briancappello/level-2-ev-charge-bridge/datasheets/README.md

# Datasheets

Reference documents for the 9.6 kW Level 2 EVSE build (`../cb-l2-evse.html`).
The eval board's KiCad files are in `../cb-eval-board/`.

| Part | Ref | File |
|---|---|---|
| ChargeBridge module (CB-CCS-EVSE-LU), v1.2 Jan 2026 | A1 | `Pionix_ChargeBridge_Module_Datasheet_v1.2_Jan-2026.pdf` |
| CB-EVAL evaluation board, v1.1 Jun 2025 (J11 pin table is out of date; the v1.2 schematic is authoritative) | A1 | `Pionix_CB-EVAL_Datasheet_v1.1_Jun-2025.pdf` |
| TI TPS27S100 high-side switch (the board's relay drivers) | A1 | `TI_TPS27S100_high-side_switch.pdf` |
| Phoenix UM-PRO-SKT-B108-L120-7035 board housing | — | `Phoenix_UM-PRO-SKT-B108-L120-7035_1456980.pdf` |
| Phoenix UT 16 feed-through terminal | TB1 | `Phoenix_UT16_3044199.pdf` |
| Phoenix UT 16-PE ground terminal | PE1–PE3 | `Phoenix_UT16-PE_3044212.pdf` |
| ABB ESB63-20N-01 contactor | K1 | `ABB_ESB63-20N-01_product_sheet.pdf` |
| ABB ESB/EN installation contactor catalog (dimensions, terminal layout) | K1 | `ABB_ESB-EN_installation_contactors_catalog.pdf` |
| ABB EH04-11N auxiliary contact | K1 aux | `ABB_EH04-11N_aux_contact.pdf` |
| Shelly EM Gen3 user and safety guide | M1 | `Shelly_EM_Gen3_user_guide.pdf` |
| Eastron SDM230-Modbus manual V1.9 (earlier M1, replaced) | — | `Eastron_SDM230-Modbus_manual_V1.9.pdf` |
| Yageo Nexensos EC3032 (5016951) and EC series PT1000 probes | TT1, TT2 | `Yageo_Nexensos_EC3032_5016951.pdf`, `Yageo_Nexensos_EC-series_PT1000.pdf` |
| Mean Well HDR-60 series | PS1 | `MeanWell_HDR-60_spec.pdf` |
| Eaton FAZ-C2/2 MCB (two revisions) | F1, F2 | `Eaton_FAZ-C2-2_datasheet.pdf`, `Eaton_FAZ-C2-2_datasheet_alt-rev.pdf` |
| Eaton FAZ family spec (AutomationDirect) | F1, F2 | `AutomationDirect_Eaton_FAZ_spec.pdf` |
| Schneider XB5AA31 pushbutton (earlier S2, replaced by GCX1100) | — | `Schneider_XB5AA31_pushbutton.pdf` |
| Schneider XB5AVB3 pilot light | H1 | `Schneider_XB5AVB3_pilot_light.pdf` |
| AutomationDirect GCX 22 mm operators (GCX3131 E-stop, GCX1100 pushbuttons) | S1, S2, S3 | `AutomationDirect_GCX_22mm_operators_spec.pdf` |
| Bimed cable glands catalog | glands | `Bimed_cable_glands_catalog.pdf` |
| Bimed glands spec (AutomationDirect) | glands | `AutomationDirect_Bimed_glands_spec.pdf` |
| Bimed BM-ENX-15-W M40 gland, spec and drawing | glands | `Bimed_BM-ENX-15-W_M40.pdf`, `Bimed_BM-ENX-15-W_M40_drawing.pdf` |
| Bimed BM-ENX-12-W M20 gland, spec and drawing | glands | `Bimed_BM-ENX-12-W_M20.pdf`, `Bimed_BM-ENX-12-W_M20_drawing.pdf` |

Not included: Polycase ZH-161407 and DR-62 (the site blocks automated downloads; the saved product page is in `../polycase/`), Phoenix D-UT 16, E/UK and FBS 2-12 accessories and the Inteset J1772 cable.
