briancappello/level-2-ev-charge-bridge/scripts/data/prices/groupA.md

| Ref | Item | MPN | Vendor | URL | Unit price (USD unless stated) | Qty | Stock / notes |
|---|---|---|---|---|---|---|---|
| A1 | ChargeBridge Evaluation Kit CCS – EVSE side (EVAL carrier board + CB-CCS-EVSE-LU module + 24 V PSU) | CB-EVAL-CCS-EVSE-LU-KIT | Pionix (shop.pionix.com) | https://shop.pionix.com/products/chargebridge-development-kit-pn-1015 | **€750.00 (EUR, net, excl. VAT)** | 1 | Shopify shows available. Store says "prices shown are net prices". United States is in the country selector. Shipping policy: Rest of World €200 (0–5 kg), €280 (>5.1 kg); EU €150; DE €40/€60. US duties/tariffs not stated. Kit includes a 24 V power supply. |
| A1 (ref) | [Bundle] ChargeBridge Evaluation Kit – EVSE + CAR side | — | Pionix | https://shop.pionix.com/products/chargebridge-evaluation-kit-evse-car-side | €1,600.00 (EUR, net) | 1 | Available. For reference: car-side kit alone (CB-EVAL-CCS-EV-LU-KIT) is €950; AC charger kit (pn-1016) is €750. |
| — | Phoenix Contact UM-PRO housing set for 108×120 mm PCB (incl. 2 side elements) | UM-PRO-SKT-B108-L120-7035 (Phoenix PN 1456980) | WSU Industrials (Germany) | https://wsu-industrials.com/en/phoenix-contact-1456980-housing-set-um-pro-skt-b108-l120-7035 | €11.49 (EUR, incl. German VAT, plus shipping; regular price €17.67) | 1 | Not on Digi-Key (no results for the MPN or for 1456980). US shipping from WSU not checked. Phoenix US site and Octopart blocked the bot. Alternative US source: Neff Automation, https://shop.neffautomation.com/products/1456980 ("contact for availability", no price). |
| — | (Fallback) Phoenix UM 108 profile base, 1000 mm × 108 mm, cut to length | 2907525 | Digi-Key | https://www.digikey.com/en/products/result?keywords=UM108-PROFIL | $119.31 | 1 | 14 in stock, **Last Time Buy**. You also need UM108 DIN-rail foot elements (not priced). Costly for one board, so the UM-PRO set above is the better buy. |
| U1 | Raspberry Pi 5 4GB | SC1111 (PiShop SKU 4GB-9024) | PiShop.us (authorized reseller) | https://www.pishop.us/product/raspberry-pi-5-4gb/ | $110.00 | 1 | IN STOCK |
| U1 (opt.) | DIN-rail ABS case for Raspberry Pi 5 | PI5-CASE-DIN-RAIL-B (Waveshare SKU 26682) | Waveshare (ships from China) | https://www.waveshare.com/pi5-case-din-rail-b.htm | $3.99 (qty 1–9) | 1 | Nice-to-have. Shipping not checked. Also sold on Amazon US: https://www.amazon.com/clp/B0CT865FQP (price not shown). |
| PS2 | Mean Well DIN-rail DC-DC, 9–36 V in, 5 V 6 A, 30 W | DDR-30G-5 | TRC Electronics (Mean Well authorized distributor) | https://www.trcelectronics.com/products/mean-well-ddr-30g-5 | $35.36 (5+: $33.57) | 1 | In stock: 50. Site says import tariff is included in the price. Digi-Key: "no longer available". Newark: $37.68, 93 in stock (UK stock), https://www.newark.com/mean-well/ddr-30g-5/dc-dc-converter-5v-6a/dp/01AH7065 |
| PS1 | Mean Well DIN-rail AC/DC 24 V 2.5 A 60 W | HDR-60-24 | Digi-Key (1866-2249-ND) | https://www.digikey.com/en/products/detail/mean-well-usa-inc/HDR-60-24/7703804 | $20.90 | 1 | In stock: 2,367 |
| R1, R2 | 2.2 kΩ 1% 0.5 W axial metal film | MFR50SFTE52-2K2 (Yageo) | Digi-Key | https://www.digikey.com/en/products/result?keywords=MFR50SFTE52-2K2 | $0.10 (Cut Tape) | 2 | 28,416 in stock, no minimum (qty 1). Alternative: Vishay SFR25H0002201FR500, $0.18, 3,296 in stock. Avoid MFR-50FRF52-2K2: Digi-Key doesn't stock it and sells only full reels. |
| R3 | 4.7 kΩ 1% 0.5 W axial metal film | MFR50SFTE52-4K7 (Yageo) | Digi-Key | https://www.digikey.com/en/products/result?keywords=MFR50SFTE52-4K7 | $0.10 | 1 | Exact match listed at $0.10. Stock count not shown in the captured text. |
| TT1, TT2 | Pt1000 2-wire RTD surface sensor, self-adhesive patch, PFA leads, 2 ft | P2A-TAPE-REC-PK-1-PFXX-24-STWL | Evolution Sensors (evosensors.com, US) | https://evosensors.com/products/2-wire-rtd-pt1000-surface-temperature-sensor-with-self-adhesive-patch-and-with-2-4-or-8ft-of-lead-wire | $50.00 (4 ft $55, 6 ft $58, 8 ft $63) | 2 | Available. Ring-lug option: 2-wire Pt1000 bolt-on with 20 ft leads, P2A-BDFT-REC-PK-0.31-PFXX-240-STWL, $90, available. |

**Not verified:**
- Pionix: no US-specific shipping terms, duties, or lead time are stated. € prices are net; whether a US order is charged VAT wasn't confirmed. No USD price is shown.
- UM-PRO-SKT-B108-L120-7035: no US-based distributor price found. Digi-Key doesn't carry it, Mouser was skipped, and Phoenix/Octopart/Arrow blocked the bot. The WSU price is a German shop's, and US shipping wasn't confirmed. UM108 foot elements for the fallback weren't priced.
- MFR50SFTE52-4K7: stock quantity not shown in the captured page. The 2.2 kΩ version shows 28,416 in stock.
- Waveshare case: shipping cost and time to the US not checked. The Amazon US listing's price wasn't fetched.
