briancappello/level-2-ev-charge-bridge/scripts/data/prices/groupB.md

| Ref | Item | MPN | Vendor | URL | Unit price (USD) | Qty | Stock / notes |
|---|---|---|---|---|---|---|---|
| TB1/TB2 | Phoenix UT 16 feed-through terminal block, 16 mm², 76 A (IEC) / 85 A (UL) | 3044199 | Digi-Key (277-3254-ND) | https://www.digikey.com/en/products/detail/phoenix-contact/3044199/2426230 | $2.44 | 4 | 2,334 in stock |
| TB end cover | End cover D-UT 16 (the correct cover for UT 16) | 3047206 | Digi-Key | https://www.digikey.com/en/products/result?keywords=3047206 | $0.74 | 1–2 | 1,956 in stock (shown as an associated product on the 3044199 page: "End Plate For CLIPLINE UT"). **Not 3047293**: that part is D-UTTB, the cover for the double-level UTTB blocks |
| TB end clamp | End clamp E/UK | 1201442 | Digi-Key | https://www.digikey.com/en/products/result?keywords=1201442 | $1.53 | 2 | In stock |
| PE | UT 16-PE ground terminal, green-yellow | **3044212** | Digi-Key (277-3344-ND) | https://www.digikey.com/en/products/detail/phoenix-contact/3044212/2435394 | price not shown | 1 | Page loaded without a price, then Cloudflare blocked the retry. **3044225 is the wrong part number**: Digi-Key lists it as a gray feed-through block for 1/0–14 AWG (UT 35 size), $5.24 |
| K1 | ABB ESB63-20N-01 installation contactor, 2NO, 63 A AC-1, 24 V AC/DC coil | ESB63-20N-01 / 1SAE351111R0120 | TME (US site, ships from Poland) | https://www.tme.com/us/en-us/details/esb63-20n-01/contactors-installation-modular/abb/1sae351111r0120/ | $115.48 (TME says customs and tariffs are included) | 1 | 4 in stock at TME |
| K1 (alt. seller) | same | 1SAE351111R0120 | Amazon, sold by Kempston Controls USA | https://www.amazon.com/1SAE351111R0120-ESB63-20N-01-ABB-Installation-CONTACTOR/dp/B097HMNFFJ | price not shown (search snippet said $377.57) | 1 | Wiautomation US shows $106.72 in its search snippet, but the page was blocked by Cloudflare |
| K1 aux | ABB EH04-11N auxiliary contact, 1NO+1NC, for ESB..N / EN..N | EH04-11N / 1SAE901901R1011 | TME | https://www.tme.com/us/en-us/details/eh04-11n/contactors-installation-modular/abb/1sae901901r1011/ | $26.12 | 1 | 105 in stock |
| F1/F2 opt. A | 2-pole Class CC DIN fuse holder, 30 A 600 V | EHCC2DU (Edison/Eaton) | AutomationDirect | https://www.automationdirect.com/adc/shopping/catalog/circuit_protection_-z-_fuses_-z-_disconnects/fuse_holders/modular_fuse_holders/ehcc2du | $52.00 | 1 | 66 available. The page warns of possible extended lead times |
| F1/F2 opt. A | Class CC 2 A time-delay fuse | HCTR2 (Edison) | AutomationDirect | https://www.automationdirect.com/adc/shopping/catalog/circuit_protection_-z-_fuses_-z-_disconnects/fuses/current_limiting_class_cc_fuses/hctr2 | $207.00 per pack of 10 | 1 pk | Backordered, earliest 10/30/2026 |
| F1/F2 opt. A' | Littelfuse 2-pole Class CC holder with blown-fuse indicator | LPSC002ID | Amazon (seller ZenSupplyInc) | https://www.amazon.com/Littelfuse-LPSC002ID-POWR-SAFE-Holder-Indicator/dp/B00JV3ED5U | $137.84 | 1 | 11 left, plus $11.99 shipping. Distributor price not obtained |
| F1/F2 opt. A' | Littelfuse Class CC 2 A time-delay fuse | KLDR002 | Amazon (seller Witonics of USA) | https://www.amazon.com/Littelfuse-KLDR-2-KLDR002-2Amp-Cartridge/dp/B00O6Y7ZHC | $9.09 each | 2 | In stock. Other sellers from $5.59 |
| F1/F2 opt. B | Eaton FAZ 2-pole 2 A C-curve MCB, UL 489, 277/480 V | FAZ-C2/2-NA | AutomationDirect (FAZ-C2-2-NA) | https://www.automationdirect.com/adc/shopping/catalog/circuit_protection_-z-_fuses_-z-_disconnects/circuit_breakers_-a-_circuit_protectors/miniature_circuit_breakers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 | $86.00 | 1 | 14 available |
| F1/F2 opt. B' | Eaton FAZ 2-pole 2 A C-curve supplementary protector, UL 1077 | FAZ-C2/2 | AutomationDirect (FAZ-C2-2) | https://www.automationdirect.com/adc/shopping/catalog/circuit_protection_-z-_fuses_-z-_disconnects/circuit_breakers_-a-_circuit_protectors/miniature_supplementary_pr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 | $46.00 | 1 | 94 available. UL 1077 is supplementary protection only, not branch-circuit protection. WMS2C02 is retired at AutomationDirect |
| SPD | Eaton CHSPT2ULTRA whole-home Type 2 SPD, 120/240 V, 108 kA | CHSPT2ULTRA | Amazon (seller FARA KITCHEN STORE) | https://www.amazon.com/EATON-CHSPT2ULTRA-SURGE-PROTECTOR-108KA/dp/B00DJS8MGY | $180.00 | 1 | In stock, $10 delivery. Third-party seller. Plugs into a CH load-center slot, so it is **not DIN-rail mounted**. Home Depot and Lowe's pages did not load |
| DIN rail | 35 × 7.5 mm slotted steel DIN rail, 1 m | DN-R35S1-2 (DINnector) | AutomationDirect | https://www.automationdirect.com/adc/shopping/catalog/wire_-a-_cable_management/din_rail/din_rail/dn-r35s1-2 | $9.25 per pack of 2 × 1 m | 1 pk | 590 available. Alternative: Phoenix 1206421, 2 m slotted, $16.32 at Digi-Key (in stock) |

**Could not verify**
- UT 16-PE (3044212): no Digi-Key price because Cloudflare blocked the page. The correct part number is 3044212, not 3044225.
- 3047293 is D-UTTB, the wrong end cover. Use D-UT 16 (3047206).
- ESB63 on Wiautomation ($106.72) and Amazon/Kempston ($377.57): these prices come from search snippets only, because the pages were blocked or not fetched. TME's $115.48 was seen on the page. I found no ABB-authorized US distributor price. The ESB63 is available to US buyers, so I did not price an alternative contactor.
- Digi-Key was blocked by Cloudflare for LPSC002ID, KLDR002, CHCC2DU and FNQ-R-2. The Amazon prices above come from third-party sellers.
- EH04-11N minimum switching load: >17 V / >5 mA. This figure comes from a reseller page (wheat-industrial.com). I could not fetch ABB's own datasheet to confirm it. Rated 6 A thermal; AC-15: 3 A at 415 V; DC-13: 0.55 A at 125 V.
