briancappello/level-2-ev-charge-bridge/scripts/data/prices/groupC.md

# Group C pricing (checked 2026-10-26, ship-to US)

| Ref | Item | MPN / description | Vendor | URL | Price (USD) and unit | Qty needed | Stock / notes |
|---|---|---|---|---|---|---|---|
| CB1 | 50 A 2-pole GFCI breaker (QO) | Square D QO250GFI | Amazon | https://www.amazon.com/SQUARE-QO250GFI-Circuit-Breaker-240V-AC/dp/B07SSF49TM | $135.00 each | 1 (one of the CB1 options) | "Only 4 left in stock". Home Depot (QO250GFIC, https://www.homedepot.com/p/Square-D-QO-50-Amp-2-Pole-GFCI-Circuit-Breaker-QO250GFIC-QO250GFIC/202495832) and Lowe's blocked the bot, so their prices were not shown |
| CB1 | 50 A 2-pole GFCI breaker (Siemens QP) | Siemens QF250A | Amazon (shipped and sold by Amazon.com) | https://www.amazon.com/Siemens-QF250A-Ground-Circuit-Interrupter/dp/B01H04XG6S | $109.75 each | 1 (option) | In stock. Other sellers start at $92.00. HD QF250AP (https://www.homedepot.com/p/Siemens-50-Amp-Double-Pole-Type-QPF-GFCI-Circuit-Breaker-US2-QF250AP/206965332): price not shown (blocked) |
| CB1 | (alt vendor) | Siemens QF250A | SuperBreakers | https://superbreakers.com/products/siemens-qf250a-50-amp | $179.80 each | – | Shows as available |
| CB1 | 50 A 2-pole GFCI breaker (Eaton BR) | Eaton BRN250GF (current pigtail version of BR250GF) | Amazon (sold by FLARETEK, ships from Amazon) | https://www.amazon.com/Eaton-BRN250GF-Circuit-Breaker-Two-Pole/dp/B0CTS1TWHF | $88.75 each | 1 (option) | In stock. HD BRN250GFCS (https://www.homedepot.com/p/Eaton-BR-50-Amp-120-Volt-240-Volt-2-in-2-Pole-GFCI-Circuit-Breaker-Pigtail-Neutral-BRN250GFCS/326936267): price not shown (blocked). SimplyBreakers lists it at $150.99 (in stock); BreakerOutlet at $99.90 (sold out). Eaton CH GFTCB250: not priced |
| W1 | 6/2 NM-B W/G, stranded, 50 ft coil | Southwire Romex SIMpull 28894422 | Amazon (sold by TheHardwareCityCom, ships from Amazon) | https://www.amazon.com/dp/B00PDF1FOM | $180.93 per 50 ft coil | 1 coil (or as the run needs) | In stock. SupplyHouse: $362.85 per 50 ft (backordered). HardPowerSystems: $207.00 per 50 ft. HD (https://www.homedepot.com/p/Southwire-50-ft-6-2-Stranded-Romex-SIMpull-CU-NM-B-W-G-Wire-28894422/205357757): price not shown |
| – | 8 AWG stranded THHN/THWN-2 Cu (black, red, green) | Cut to length, SKU THN8 | Wire & Cable Your Way | https://www.wireandcableyourway.com/8-awg-thhn-building-wire | $0.87 per ft | ~3–6 ft per colour | Stranded confirmed (category "Stranded THHN/THWN-2"). Black and Green are in the colour list; Red not confirmed. $20 minimum order |
| – | Ferrule kit with 10 mm² (8 AWG) ferrules + ratchet crimper | LUNEY 1250 pcs, AWG 23-7 (0.25–10 mm²) | Amazon (sold by panda mimi, ships from Amazon) | https://www.amazon.com/dp/B0B23V7ZQJ | $13.98 per kit | 1 | In stock |
| – | 18 AWG stranded MTW, blue | Atlas MTW18BL, 500 ft spool | AutomationDirect | https://www.automationdirect.com/adc/shopping/catalog/bulk_wire_-a-_cable/single_conductor_wire_-a-_cable/mtw18bl | $49.00 per 500 ft spool | ~10 ft | Backordered, earliest 11/12/2026. Alt: Wire & Cable Your Way MTW18 (https://www.wireandcableyourway.com/18-awg-type-mtw-ul1015-wire-16-strand-500-or-1000-spool) at $0.13/ft, sold by spool only (500/1000 ft) |
| – | RS-485 shielded twisted pair | Belden 9841, 24 AWG 1 pair, shielded, 120 Ω | Wire & Cable Your Way | https://www.wireandcableyourway.com/belden-9841-24-awg-1-pair-shielded-low-capacitance-computer-cable | $3.55 per ft | ~3–6 ft | Stock not shown. $20 minimum order |
| X1 | J1772 tethered cable, 48 A, 25 ft (option 1) | Inteset 48A J1772 replacement cable, 8 AWG, bare-wire charger end, Made in USA | Amazon (Inteset) | https://www.amazon.com/Inteset-Charger-Replacement-Original-Chargers/dp/B0FV116C88 | $219.95 each | 1 | "Only 2 left in stock". 48 A continuous, 25 ft, IP65. Listing does not say whether there is a latch-button sense wire. A 40 A 25 ft version from the same search was $179.95 (URL not captured) |
| X1 | J1772 tethered cable, 48 A, 25 ft (option 2) | Phoenix Contact EV-T1G2C-1AC48A-25FT12ASBK11U ("Standard" ferrule termination) | OpenEVSE store | https://store.openevse.com/products/j1772-cable-48a-ultra-flexible | $229.00 each | 1 | Backordered, 3–4 week lead time. cULus, 48 A max. 9 conductors (4×12 AWG, 1×10 AWG, 4×22 AWG). Sense wire not explicitly stated |
| – | J1772 wall holster / dock | J1772 Wall Mount EV Plug Holder | EVSE Adapters | https://www.evseadapters.com/products/j1772-plug-holder | $9.95 each | 1 | Available. OpenEVSE holster v2 is $24.99 but sold out |
| M1 | Eastron SDM230-Modbus, 100 A, RS-485 | "SDM230 … RS485/Modbus Output Non MID" (unbranded listing) | Amazon (seller chenhongqingCHQ) | https://www.amazon.com/SDM230-Single-Energy-Bi-Directional-Function/dp/B0DKFF2Z83 | $41.00 each | 1 | Non-MID. In stock, but delivery is Nov 5–13, so it likely ships from overseas. Genuine Eastron not verified |
| M1 | (alt) | YYAZYYZ SDM230-Modbus MID | Amazon (third party) | https://www.amazon.com/YYAZYYZ-SDM230-Modbus-Energy-Communicate-Systems/dp/B0G5Y9BVXW | $79.10 each | – | MID version. Delivery Nov 13–24, so it ships from overseas. No US-located genuine Eastron seller found (eBay US search: 0 exact results) |
| RCM1 | 6 mA DC RCM module, relay output | Littelfuse/Western Automation RCM14-03 | Digi-Key | https://www.digikey.com/en/products/detail/littelfuse-western-automation/RCM14-03/19183160 | $36.38 each (qty 1) | 1 (optional) | In stock: 97. Tariff may apply |
| RCM1 | (alt) | Littelfuse/Western Automation RCM14-01 | Digi-Key | https://www.digikey.com/en/products/detail/littelfuse-western-automation/RCM14-01/19183167 | $36.38 each (qty 1) | – | In stock: 160. No backorders accepted |

**Could not verify:**
- Home Depot and Lowe's blocked the bot, so no HD/Lowe's prices for any breaker, the Romex or the 8 AWG wire.
- Eaton CH GFTCB250: not priced. Eaton BRN250GF was priced instead of BR250GF, which has been superseded by the pigtail BRN version.
- 8 AWG red THHN in stock at Wire & Cable Your Way (only black and green confirmed). Also no 25 ft spool price.
- Whether either J1772 cable has a latch-button sense wire (neither listing says).
- The Amazon SDM230 listings are unbranded third-party sellers shipping from overseas. Genuine Eastron is not confirmed, and no US-stock seller was found.
- No price for a Bender, Dold or UL CCID20 alternative for RCM1 (not searched further, since the RCM14 parts are in stock at Digi-Key).
- Mouser was not checked because it blocks the bot.
