briancappello/level-2-ev-charge-bridge/scripts/data/prices/groupD.md

| Ref | Item | MPN | Vendor | URL | Unit price (USD) | Qty | Stock / notes |
|---|---|---|---|---|---|---|---|
| S1 | E-stop, 22 mm, 40 mm red mushroom, turn-to-release, 1 NC | Schneider XB5AS8444 | Digi-Key | https://www.digikey.com/en/products/result?keywords=XB5AS8444 | $121.28 | 1 | Exact match on Digi-Key search. Stock count not shown on the results page. |
| S1 extra | Add-on contact block, 1 NC, screw clamp | Schneider ZBE102 | Digi-Key | https://www.digikey.com/en/products/result?keywords=ZBE102 | $12.05 | 1 | Correct part: Schneider/dealer pages say ZBE102 fits both XB4 (metal) and XB5 (plastic). ZB5AZ102 is a body with a fixing collar, not an add-on block. Stock count not shown. |
| S2 (preferred) | 22 mm pushbutton, black, spring return (momentary), 1 NO | Schneider XB5AA31 | Digi-Key | https://www.digikey.com/en/products/result?keywords=XB5AA31 | $28.30 | 1 | Momentary NO, matches the input requirement. Stock count not shown. |
| S2 (alt) | 22 mm key selector, 2-position, stay-put (maintained), 1 NO | Schneider XB5AG21 | Digi-Key | https://www.digikey.com/en/products/result?keywords=XB5AG21 | $90.41 | 1 | Maintained, not momentary. Stock count not shown. |
| H1 | 22 mm LED pilot light, 24 V AC/DC, green | Schneider XB5AVB3 | Digi-Key | https://www.digikey.com/en/products/result?keywords=XB5AVB3 | $52.92 | 1 | Digi-Key's short description says "30MM", which looks like a listing error (XB5AV is a 22 mm series). Stock count not shown. |
| H1 (alt) | 22 mm LED pilot light, 24 V AC/DC, red | Schneider XB5AVB4 | Digi-Key | https://www.digikey.com/en/products/result?keywords=XB5AVB4 | $52.92 | 1 | Same as above. |
| Encl (opt A) | NEMA 4X polycarbonate enclosure, 16 x 14 x 7 in, clear hinged door, quick-release latch | Integra H161407HCFNL-P10 | AutomationDirect | https://www.automationdirect.com/adc/shopping/catalog/enclosures_-a-_racks/wall-mount_enclosures/h161407hcfnl-p10 | $214.00 | 1 | 11 available. Free delivery. Subpanel sold separately. |
| Encl plate (opt A) | Subpanel for the enclosure above, 3003 aluminum | Integra ABP-1614-P10 | AutomationDirect | (same page, Related Items) | $46.50 | 1 | 7 available. Other subpanels: steel SBP-1614-P10 $64.00 (35 avail.), PVC PVCBP-1614-P10 $57.00 (68 avail.). |
| Encl (opt B) | Fibox ARCA polycarbonate hinged enclosure, 400 x 300 mm, IP66/NEMA 4X, no mounting plate | Fibox ARCA 403021 NO MP | Digi-Key | https://www.digikey.com/en/products/detail/fibox-enclosures/ARCA-403021-NO-MP/21841278 | $306.83 | 1 | In stock: 0, 12-week factory lead time. Digi-Key lists the height as 152.5 mm (6.0 in). Ships separately as a large item. |
| Encl plate (opt B) | Mounting plate for ARCA 4030 | Fibox MPS ARCA 4030 | Digi-Key | https://www.digikey.com/en/products/detail/fibox-enclosures/MPS-ARCA-4030/11505263 | $41.85 | 1 | 13 in stock. |
| Encl (opt C) | Polycase ZH series polycarbonate, 16 x 14 x 8.2 in, NEMA 4X/6P, stainless latch | Polycase ZH-161407-90 | Polycase | https://www.polycase.com/zh-161407 | $117.35 (qty 1-9 tier) | 1 | Panel ZX-1614K only showed "as low as $23.56", not a qty-1 price. Stock not shown. |
| Encl (opt D, ref) | Hammond PJ 16 x 14 x 8 in (fiberglass, not polycarbonate) | Hammond PJ16148 | Digi-Key | https://www.digikey.com/en/products/result?keywords=PJ1614 | $222.59 | 1 | 7 in stock. Fiberglass. The Hammond polycarbonate PCJ16148 is a different size (15.04 x 9.44 in). PJ1614PP was not found on Digi-Key. |
| Gland M40 | Cable gland M40x1.5, polyamide, IP68, 19-28 mm cable, light gray, with mounting hardware (locknut) | Bimed BM-ENX-15-W | AutomationDirect | https://www.automationdirect.com/adc/shopping/catalog/wire_-a-_cable_management/cable_glands/metric_thread | $9.25 per 2-pack | 1 pack | 33 available. The black version BM-ENX-25-W is the same price but backordered until 1/21/2027. |
| Gland M32 | Cable gland M32x1.5, polyamide, IP68, 15-21 mm cable, with mounting hardware (locknut) | Bimed BM-ENX-24-W (black) / BM-ENX-14-W (gray) | AutomationDirect | https://www.automationdirect.com/adc/shopping/catalog/wire_-a-_cable_management/cable_glands/metric_thread | $12.50 per 5-pack | 1 pack | Black: 76 available. Gray: 14 available. |

Could not verify:
- Digi-Key stock counts for the Schneider operator parts (the search results page showed the price but no quantity).
- Lapp SKINTOP ST-M 40x1.5 (53111050) price: Digi-Key started returning a bot check partway through.
- Fibox "ARCA 403020"/IEC version: no Digi-Key result.
- Hammond PJ1614PP mounting plate: no Digi-Key result.
- Polycase ZX-1614K panel: no qty-1 price shown.
- M32 gland fit: the supply cable outer diameter wasn't given. If it is over 21 mm, use the M40 gland.
- I did not price NPT glands, because metric options were in stock.
