briancappello/level-2-ev-charge-bridge/scripts/sim/netlists/cp_stateA_1600pF.cir

* Control pilot, state A, 1600 pF total on CP
Vosc osc 0 PULSE(-12 12 0 1e-06 1e-06 0.0006656666666666667 1m)
Rs osc cp 1k
Cmod cp 0 300p
Ccab cp 0 1.3e-09
.model D1N4148 D(IS=2.52n RS=0.568 N=1.752 BV=100 IBV=100u CJO=4p TT=20n)
.control
tran 50n 3m
wrdata @WRDIR@/cp.dat v(cp)
.endc
.end
