briancappello/level-2-ev-charge-bridge/(commit log)

2026-10-27 Initial import: 9.6 kW L2 EVSE design on Pionix CB-EVAL
    Design document (schematics, priced BOM, assembly guide), manufacturer
    datasheets via Git LFS, generator scripts and research data, Pionix
    cb-eval-board as a submodule at tag 1.2, and the exported OpenCode
    design session.
2026-10-28 Add ngspice circuit simulations, CI, and kicad-cli net lookup
    scripts/sim/run.py simulates the E-stop loop, relay 1 feedback, control
    pilot states A-D and the PT1000 front end with 21 pass/fail checks, and
    writes a Simulations section into cb-l2-evse.html. A Simulations workflow
    runs the checks on every push.
    scripts/board_nets.py reads CB-EVAL connectivity from kicad-cli's netlist;
    netlist.py is marked unreliable (it reversed the input zeners).
    [board_nets.py, netlist.py]
2026-10-28 E-stop loop: two parallel pull-downs (R2a, R2b) so one failing open still trips
    Adds failure-mode checks to the simulation suite, the parallel pull-downs
    to Sheet 2 and the BOM, mounting guidance in assembly step 6, and a trip
    test in step 9.
    [build_assembly.py, build_bom.py]
2026-10-28 Make the E-stop standard: S1 on the right wall, S1-a in the coil, S1-b in the J4.11 loop
    Assembly steps 1, 6 and 9 place and wire S1; Sheet 2 explains S1-a/S1-b;
    BOM moves S1, its contact block and R1/R2a/R2b to required, swaps H1 for
    the $6.25 AutomationDirect ECX2052-24L, and corrects RCM1's note (12 V
    supply, open-drain output, not a relay contact).
    [build_assembly.py, build_bom.py]
2026-10-28 Complete design, no optional parts: add RCM1 (RCM14-04) with PS2, K2, S3; H1 via K1 aux
    - RCM1 on the J1772 L1/L2 holds K2 energised; K2 11-14 is in series with
    S1-b, so a fault, S3 test, lost 12 V or open K2 coil trips J4.11
    - H1 is driven by K1's aux NO 33-34 (real contactor state, no software)
    - Surge protector removed (house upgrade, not part of the unit)
    - Simulations: RCM1/K2 failure-mode checks (30/30 pass)
    - Assembly: new step 7 for safety and status wiring; TT2 moved to TB1-3
    - Generators keep their CSS in marker-delimited blocks
    - BOM total $996.92
    [build_assembly.py, build_bom.py]
2026-10-28 US-based sources for every part; K1 becomes Finder 22.64 + 022.65
    - K1: Finder 22.64.0.024.4310 (Digi-Key, $97.08) with 022.65 aux
    ($32.19, mechanically linked 1 NO + 1 NC) replaces the ABB ESB63/EH04
    from TME (Poland); ABB at Radwell noted as a US alternative
    - R3 becomes R3a || R3b (3.9 k each) for the 022.65's 10 mA minimum load
    - PS1 capped at 26.4 V (K1 coil range); simulations sweep 21.6-26.4 V
    - M1: genuine Eastron SDM230 from Radwell (NJ); EVerest has a built-in
    SDM230 profile
    - UM-PRO housing: Neff Automation (Indiana), price on request
    - BOM total $1,066.17
    [build_assembly.py, build_bom.py]
2026-10-28 M1 becomes a Shelly EM Gen3 on ESPHome; cheaper S2 and PT1000s - M1: Shelly EM Gen3 50A ($69.99, Shelly USA) flashed with ESPHome replaces the SDM230 and its RS-485 cable. Clamp on the TB1-1 to K1 L1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
    [build_assembly.py, build_bom.py]
